Alba0404/gpib-kicad-library/(commit log)

2023-05-10 Create folders to clarify and add 3 connectors from L-com (CIB24S, CIB24SPC, CIB24SRA)
2025-01-09 Modify README to include KiCad 8.0.
2025-01-09 Correct KiCad writting in badges.
