Alba0404/gpib-kicad-library/(notices)

Notices in the files:
README.md:
CC BY-SA 4.0
